122Bapuji/OpAmp2Stage_SCL1p2um/(commit log)

2026-10-03 Initial commit: Two-Stage CMOS Op-Amp in SCL 1.2 um CMOS PDK (Xschem, ngspice, KLayout, Magic)
    [opamp_2stage.sch, tb_opamp.sch]
2026-10-03 Update thesis: add high-res schematics, silicon layout diagram, and full two-sided text justification
