122Bapuji/OpAmp2Stage_SCL1p2um/(notices)

Notices in the files:
README.md:
License: Apache 2.0
